bladecell/esp32-smart-fermetation-glass/hw/smart-fermentation-glass/smart-fermentation-glass.kicad_pcb

## KiCad design hw/smart-fermentation-glass/smart-fermentation-glass.kicad_pcb (2026-11-04)

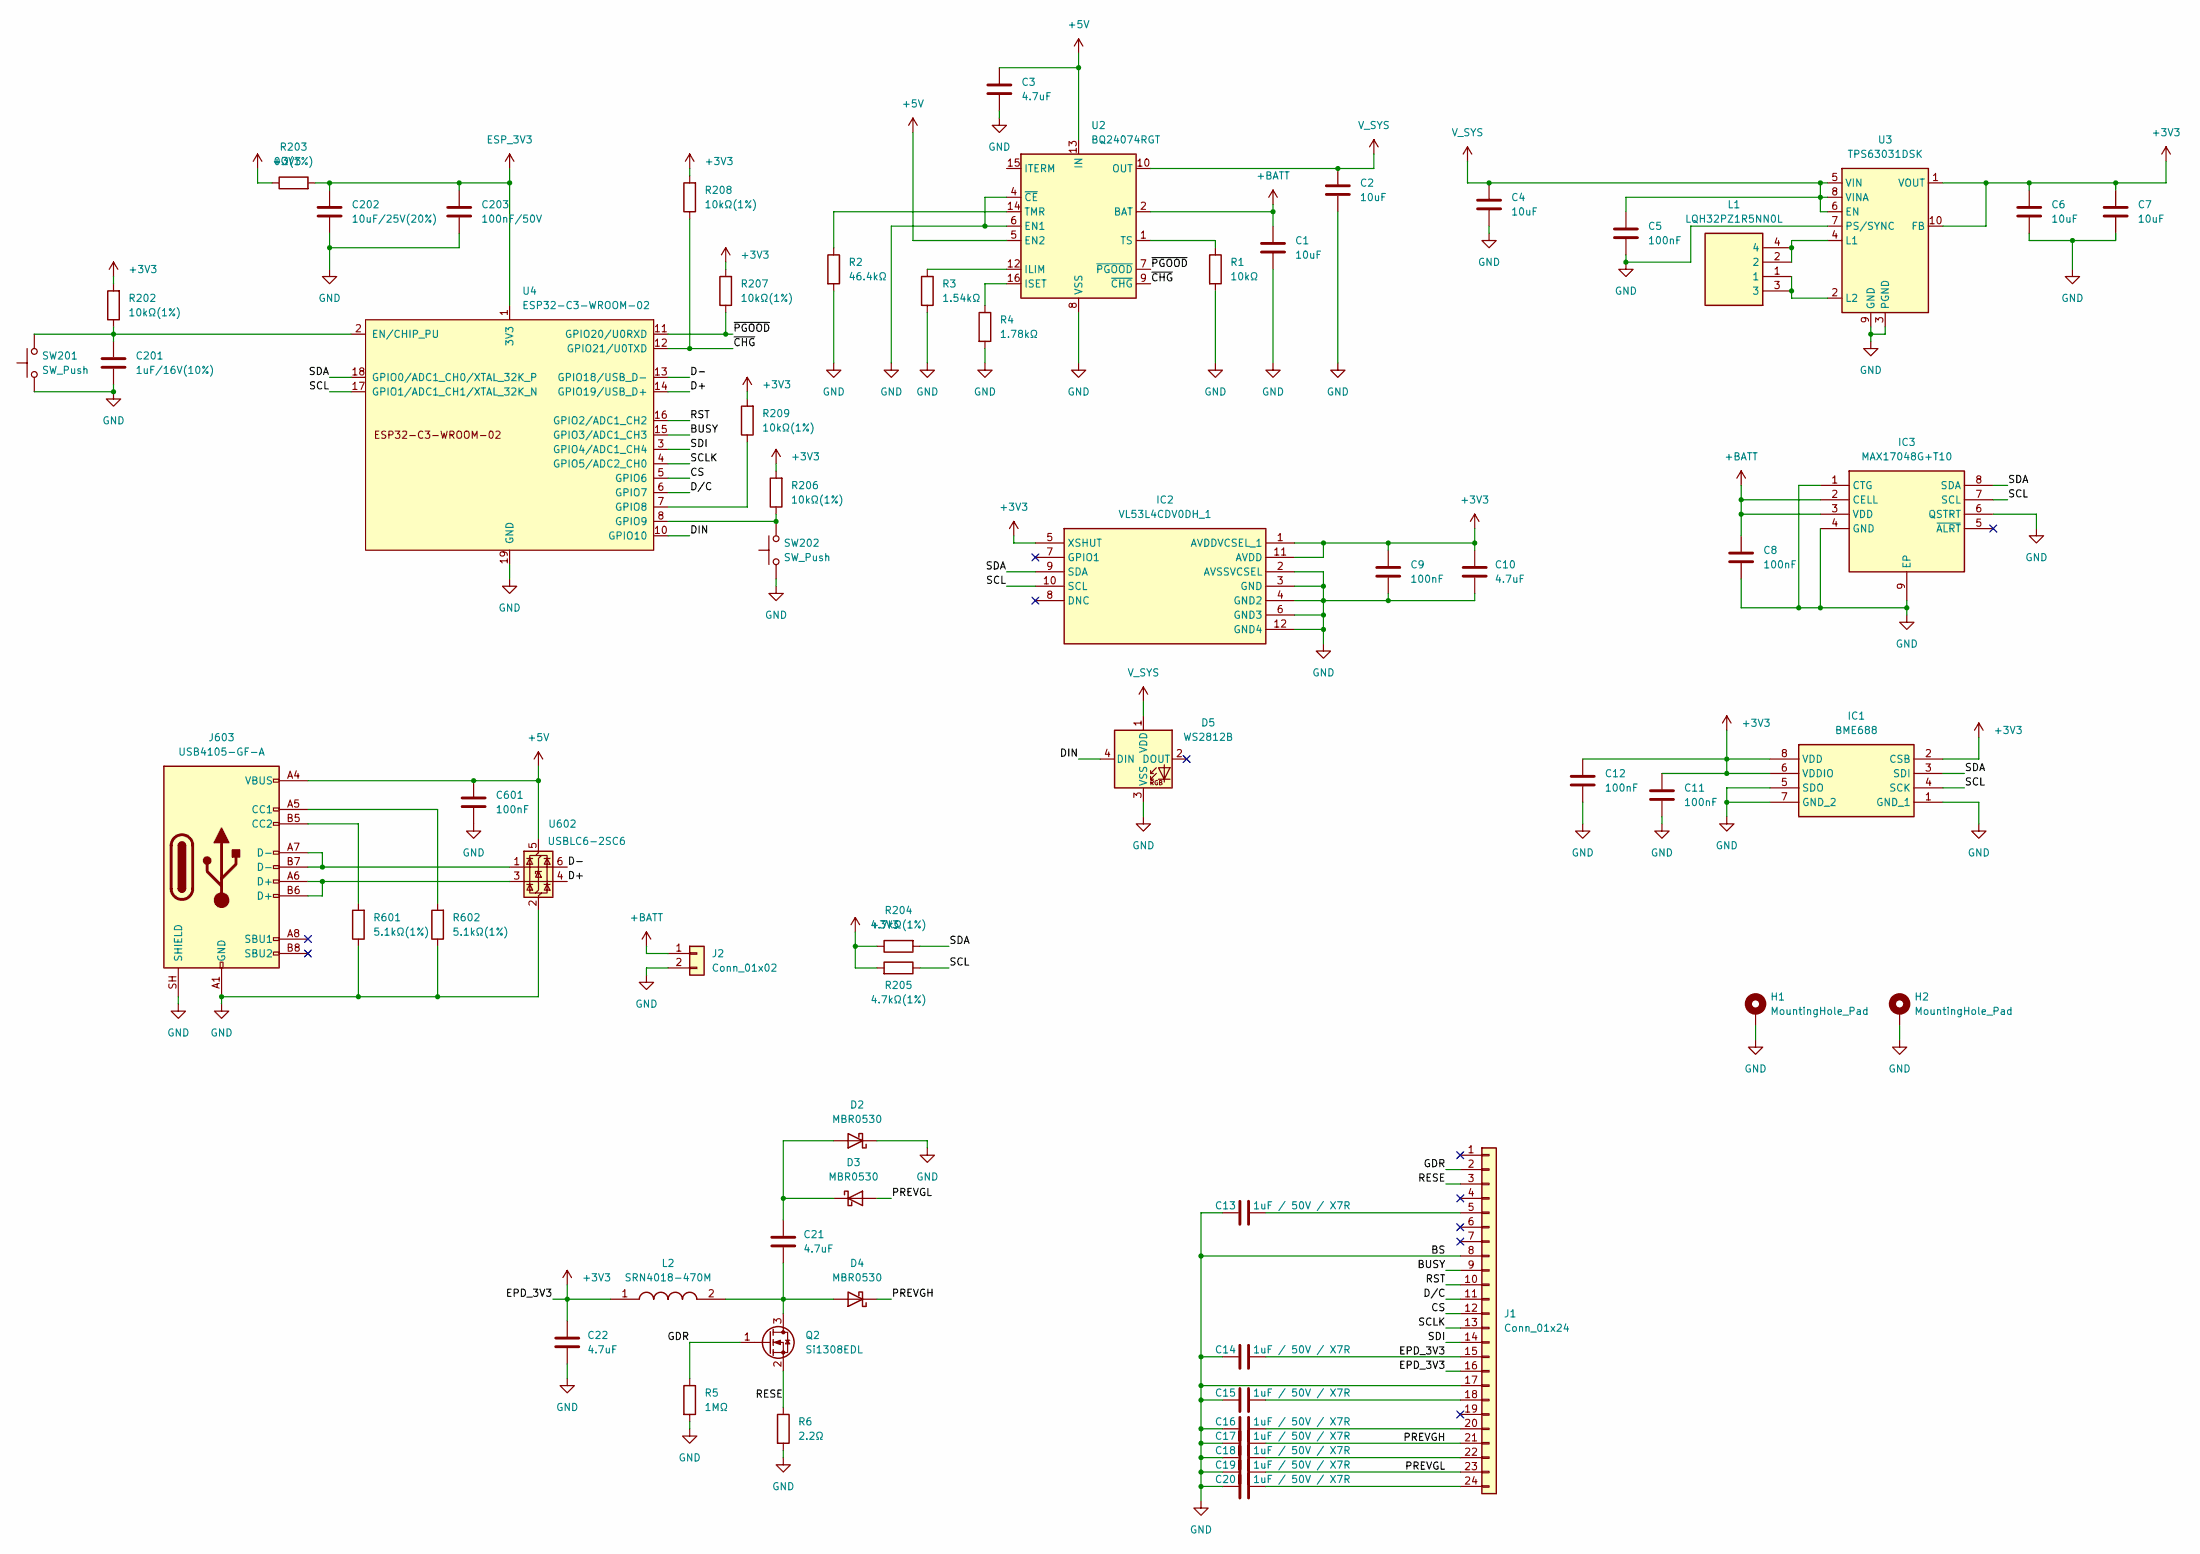
[picture p1: schematic smart-fermentation-glass.kicad_sch]

Parts:
C1, C2, C4, C6, C7: 10uF; C_0603_1608Metric; Mouser Part Number 81-GRM188R61E106MA3D
C3, C10, C21, C22: 4.7uF; C_0603_1608Metric; Mouser Part Number 81-GRM188R61C475KE1D
C5, C8, C9, C11, C12, C601: 100nF; C_0603_1608Metric; Mouser Part Number 581-06035C104KAT2A
C13, C14, C15, C16, C17, C18, C19, C20: 1uF / 50V / X7R; C_0603_1608Metric; Mouser Part Number 581-06035C105KAT2A
C201: 1uF/16V(10%); C_0603_1608Metric; Mouser Part Number 810-C1608X7R1C105K
C202: 10uF/25V(20%); C_0603_1608Metric; Mouser Part Number 81-GRM188R61E106MA3D
C203: 100nF/50V; C_0603_1608Metric; Mouser Part Number 581-06035C104KAT2A
D2, D3, D4: MBR0530; D_SOD-123; Mouser Part Number 863-MBR0530T1G
D5: WS2812B; LED_WS2812B_PLCC4_5.0x5.0mm_P3.2mm
H1, H2: MountingHole_Pad; MountingHole_3.2mm_M3_ISO14580_Pad_TopBottom
IC1: BME688; Mouser Part Number 262-BME688
IC2: VL53L4CDV0DH_1; VL53L4CDV0DH1; Mouser Part Number 511-VL53L4CDV0DH/1
IC3: MAX17048G+T10; SON50P200X200X80-9N-D; Mouser Part Number 700-MAX17048G+T10
J1: Conn_01x24; Molex_502244-2430_1x24-1MP_P0.5mm_Horizontal; Mouser Part Number 538-502244-2430
J2: Conn_01x02; JST_PH_S2B-PH-K_1x02_P2.00mm_Horizontal; Mouser Part Number 306-S2BPHKSLFSNPP
J603: USB4105-GF-A; USB_C_Receptacle_GCT_USB4105-xx-A_16P_TopMnt_Horizontal; Mouser Part Number 640-USB4105-GF-A
L1: LQH32PZ1R5NN0L; LQH32CH100K53L; Mouser Part Number 81-LQH32PZ1R5NN0L
L2: SRN4018-470M; SRN4018470M; Mouser Part Number 652-SRN4018-470M
Q2: Si1308EDL; SOT-323_SC-70; Mouser Part Number 78-SI1308EDL-T1-GE3
R1: 10kΩ; R_0603_1608Metric; Mouser Part Number 603-RC0603FR-0710KL
R2: 46.4kΩ; R_0603_1608Metric; Mouser Part Number 603-RC0603FR-0746K4L
R3: 1.54kΩ; R_0603_1608Metric; Mouser Part Number 603-RC0603FR-071K54L
R4: 1.78kΩ; R_0603_1608Metric; Mouser Part Number 603-RC0603FR-071K78L
R5: 1MΩ; R_0603_1608Metric; Mouser Part Number 603-RC0603FR-071ML
R6: 2.2Ω; R_0603_1608Metric; Mouser Part Number 603-RC0603FR-072R2L
R202, R206, R207, R208, R209: 10kΩ(1%); R_0603_1608Metric; Mouser Part Number 603-RC0603FR-0710KL
R203: 0Ω(1%); R_0603_1608Metric; Mouser Part Number 603-RC0603FR-070RL
R204, R205: 4.7kΩ(1%); R_0603_1608Metric; Mouser Part Number 603-RC0603FR-074K7L
R601, R602: 5.1kΩ(1%); R_0603_1608Metric; Mouser Part Number 603-RC0603FR-075K1L
SW201, SW202: SW_Push; SW_SPST_B3U-3000P; Mouser Part Number 653-B3U-3000P
U2: BQ24074RGT; VQFN-16-1EP_3x3mm_P0.5mm_EP1.6x1.6mm; Mouser Part Number 595-BQ24074RGTR
U3: TPS63031DSK; WSON-10-1EP_2.5x2.5mm_P0.5mm_EP1.2x2mm; Mouser Part Number 595-TPS63031DSKR
U4: ESP32-C3-WROOM-02; Mouser Part Number 356-ESP32C3WROOM02N4
U602: USBLC6-2SC6; SOT-23-6; Mouser Part Number 511-USBLC6-2SC6

Connections:
+3V3: C6.1, C7.1, C9.1, C10.1, C11.1, C12.1, C14.2, C22.1, IC1.2 (CSB), IC1.6 (VDDIO), IC1.8 (VDD), IC2.1 (AVDDVCSEL_1), IC2.5 (XSHUT), IC2.11 (AVDD), IC2.13 (AVDDVCSEL_2), J1.15, J1.16, L2.1, R202.2, R203.1, R204.1, R205.2, R206.2, R207.2, R208.2, R209.2, U3.1 (VOUT), U3.10 (FB)
+5V: C3.1, C601.1, J603.A4 (VBUS), J603.A9 (VBUS), J603.B4 (VBUS), J603.B9 (VBUS), U2.5 (EN2), U2.13 (IN), U602.5 (VBUS)
+BATT: C1.1, C8.1, IC3.2 (CELL), IC3.3 (VDD), J2.1, U2.2 (BAT), U2.3 (BAT)
/BUSY: J1.9, U4.15 (GPIO3/ADC1_CH3)
/CS: J1.12, U4.5 (GPIO6)
/D+: U4.14 (GPIO19/USB_D+), U602.4 (I/O2)
/D-: U4.13 (GPIO18/USB_D-), U602.6 (I/O1)
/DIN: D5.4 (DIN), U4.10 (GPIO10)
/D/C: J1.11, U4.6 (GPIO7)
/GDR: J1.2, Q2.1 (G), R5.1
/PREVGH: C17.2, D4.1 (K), J1.21
/PREVGL: C19.2, D3.2 (A), J1.23
/RESE: J1.3, Q2.2 (S), R6.1
/RST: J1.10, U4.16 (GPIO2/ADC1_CH2)
/SCL: IC1.4 (SCK), IC2.10 (SCL), IC3.7 (SCL), R205.1, U4.17 (GPIO1/ADC1_CH1/XTAL_32K_N)
/SCLK: J1.13, U4.4 (GPIO5/ADC2_CH0)
/SDA: IC1.3 (SDI), IC2.9 (SDA), IC3.8 (SDA), R204.2, U4.18 (GPIO0/ADC1_CH0/XTAL_32K_P)
/SDI: J1.14, U4.3 (GPIO4/ADC1_CH4)
/~CHG: R208.1, U2.9 (~CHG), U4.12 (GPIO21/U0TXD)
/~PGOOD: R207.1, U2.7 (~PGOOD), U4.11 (GPIO20/U0RXD)
ESP_3V3: C202.1, C203.1, R203.2, U4.1 (3V3)
GND: C1.2, C2.2, C3.2, C4.2, C5.2, C6.2, C7.2, C8.2, C9.2, C10.2, C11.2, C12.2, C13.1, C14.1, C15.1, C16.1, C17.1, C18.1, C19.1, C20.1, C22.2, C201.2, C202.2, C203.2, C601.2, D2.1 (K), D5.3 (VSS), H1.1 (1_1), H2.1 (1_1), IC1.1 (GND_1), IC1.5 (SDO), IC1.7 (GND_2), IC2.2 (AVSSVCSEL), IC2.3 (GND), IC2.4 (GND2), IC2.6 (GND3), IC2.12 (GND4), IC3.1 (CTG), IC3.4 (GND), IC3.6 (QSTRT), IC3.9 (EP), J1.8, J1.17, J2.2, J603.A1 (GND), J603.A12 (GND), J603.B1 (GND), J603.B12 (GND), J603.SH (SHIELD), R1.2, R2.2, R3.2, R4.2, R5.2, R6.2, R601.1, R602.1, SW201.1, SW202.1, U2.4 (~CE), U2.6 (EN1), U2.8 (VSS), U2.17 (VSS), U3.3 (PGND), U3.7 (PS/SYNC), U3.9 (GND), U3.11 (PGND), U4.9 (GND), U4.19 (GND), U602.2 (GND)
unnamed: C21.1, D2.2 (A), D3.1 (K)
unnamed: C21.2, D4.2 (A), L2.2, Q2.3 (D)
unnamed: C13.2, J1.5
unnamed: C15.2, J1.18
unnamed: C16.2, J1.20
unnamed: C18.2, J1.22
unnamed: C20.2, J1.24
unnamed: J603.A5 (CC1), R602.2
unnamed: J603.B5 (CC2), R601.2
unnamed: J603.A6 (D+), J603.B6 (D+), U602.3 (I/O2)
unnamed: J603.A7 (D-), J603.B7 (D-), U602.1 (I/O1)
unnamed: R3.1, U2.12 (ILIM)
unnamed: R4.1, U2.16 (ISET)
unnamed: R2.1, U2.14 (TMR)
unnamed: R1.1, U2.1 (TS)
unnamed: L1.2, L1.4, U3.4 (L1)
unnamed: L1.1, L1.3, U3.2 (L2)
unnamed: C201.1, R202.1, SW201.2, U4.2 (EN/CHIP_PU)
unnamed: R209.1, U4.7 (GPIO8)
unnamed: R206.1, SW202.2, U4.8 (GPIO9)
V_SYS: C2.1, C4.1, C5.1, D5.1 (VDD), U2.10 (OUT), U2.11 (OUT), U3.5 (VIN), U3.6 (EN), U3.8 (VINA)

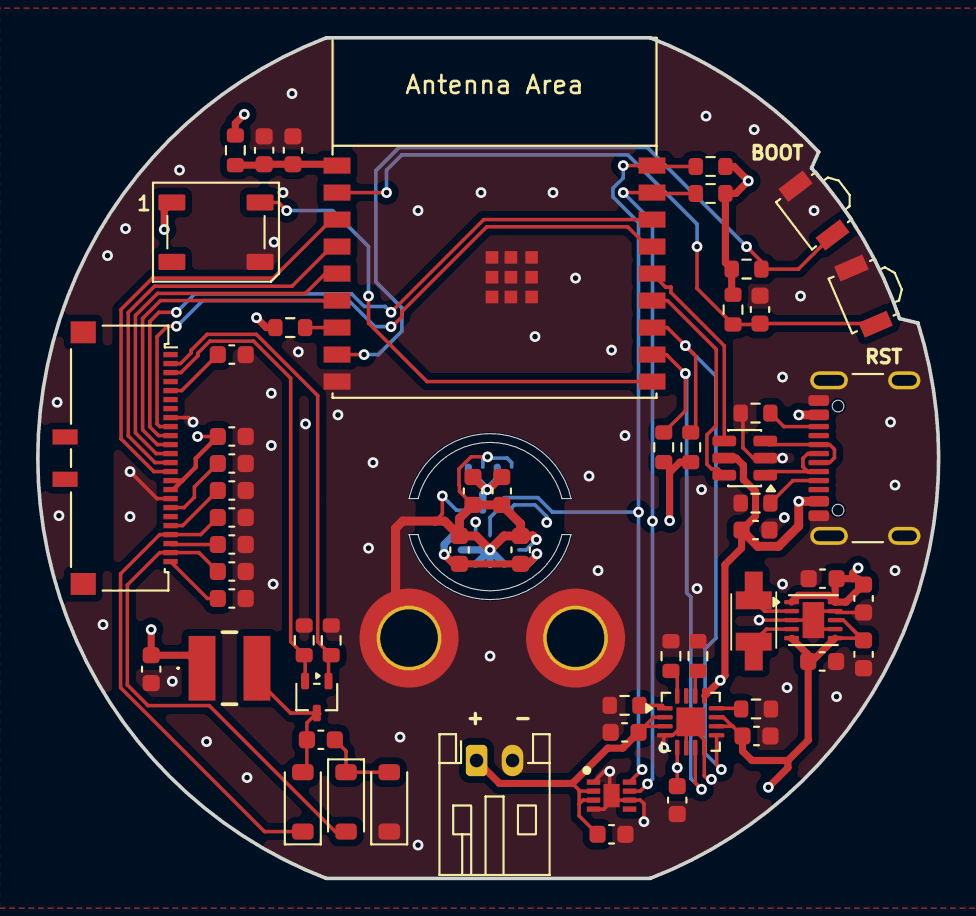
[picture p2: board smart-fermentation-glass.kicad_pcb from above]

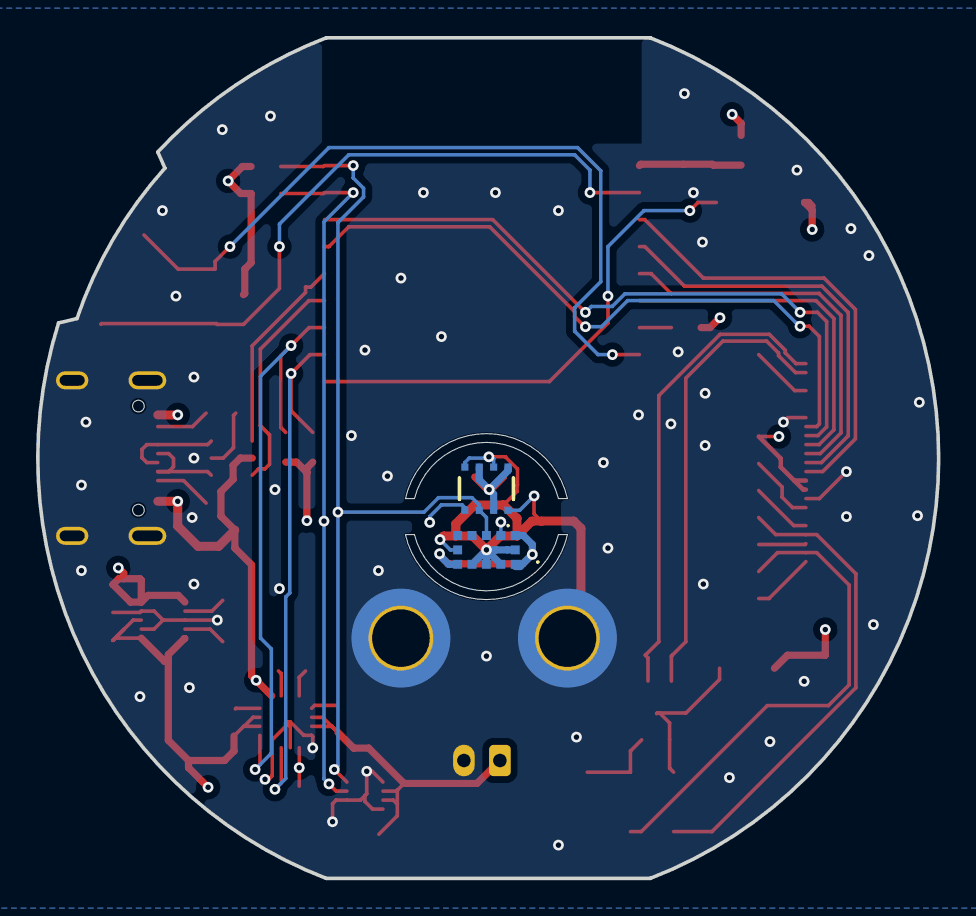
[picture p3: board smart-fermentation-glass.kicad_pcb from below]

Board: 4 copper layers, 50.0 x 46.7 mm, 63 parts (2 on the bottom side), 43 nets.
