bladecell/esp32-smart-fermetation-glass/(commit log)

2026-09-28 pcb schematics
2026-10-19 completed schematics and pcb
2026-11-04 fixed ps/sync to gnd
